konradwilk/fibonacci/(threads)

Thread 6 (2021-06-09):

remove clock buffers on outputs

mattvenn, 2021-06-09:
add this to config.tcl and re-harden. See thread in #mpw-2-prep for more details

set ::env(PL_RESIZER_BUFFER_OUTPUT_PORTS) 0

konradwilk, 2021-06-09:
Fixed in 4a7fbc5c31c69371d0a4e8706bc4d8c3d64965da

Closed 2021-06-09.
