konradwilk/fibonacci/caravel_test/test_caravel.py

# SPDX-FileCopyrightText: 2021 Konrad Rzeszutek Wilk
#
# Licensed under the Apache License, Version 2.0 (the "License");
# you may not use this file except in compliance with the License.
# You may obtain a copy of the License at
#
#      http://www.apache.org/licenses/LICENSE-2.0
#
# Unless required by applicable law or agreed to in writing, software
# distributed under the License is distributed on an "AS IS" BASIS,
# WITHOUT WARRANTIES OR CONDITIONS OF ANY KIND, either express or implied.
# See the License for the specific language governing permissions and
# limitations under the License.
# SPDX-License-Identifier: Apache-2.0
import cocotb
from cocotb.clock import Clock
from cocotb.binary import BinaryValue
from cocotb.triggers import ClockCycles, RisingEdge, FallingEdge;
from cocotb.result import TestSuccess;

@cocotb.test()
async def test_start(dut):
    clock = Clock(dut.clock, 10, units="ns")
    cocotb.fork(clock.start())

    dut.RSTB <= 0
    dut.power1 <= 0;
    dut.power2 <= 0;
    dut.power3 <= 0;
    dut.power4 <= 0;
    dut.uut.mprj.wrapper_fibonacci.wbs_dat_i.value <= 0;

    dut._log.info("Cycling power");
    await ClockCycles(dut.clock, 8)
    dut.power1 <= 1;
    await ClockCycles(dut.clock, 8)
    dut.power2 <= 1;
    await ClockCycles(dut.clock, 8)
    dut.power3 <= 1;
    await ClockCycles(dut.clock, 8)
    dut.power4 <= 1;

    await ClockCycles(dut.clock, 80)
    dut.RSTB <= 1

    dut._log.info("Waiting for active (This can take a while)");
    # wait for the project to become active
    # wrapper.v has  .active     (la_data_in[32+0])
    # wrapper.c: reg_la1_ena = 0;
    #            reg_la1_data = 1; /* 0x2500,0004 */
    await RisingEdge(dut.uut.mprj.wrapper_fibonacci.active)
    dut._log.info("Active ON");

async def test_wb(dut, i):

    ack_str = "";
    addr = int(dut.uut.mprj.wrapper_fibonacci.wbs_adr_i.value);
    data = int(dut.uut.mprj.wrapper_fibonacci.wbs_dat_o.value);
    ack = int(dut.uut.mprj.wrapper_fibonacci.wbs_ack_o.value);
    try:
        data_i = int(dut.uut.mprj.wrapper_fibonacci.wbs_dat_i.value);
    except:
        dut._log.info("%4d %s %s DATA_IN=RAW[%s] DATA_OUT=%s" % (i, hex(addr), ack_str,  dut.uut.mprj.wrapper_fibonacci.wbs_dat_i.value, hex(data)));
        pass

    if (addr >= 0x30000000):
        if (ack == 1):
            ack_str = "ACK";

        dut._log.info("%4d %s %s DATA_IN=%s DATA_OUT=%s" % (i, hex(addr), ack_str,  hex(data_i), hex(data)));

        if (ack == 0):
            return;

        if (addr == 0x30000000): # CTRL_GET_NR
            assert(data == 9);

        if (addr == 0x30000004): # CTRL_GET_ID
            assert(data == 0x4669626f);

        if (addr == 0x30000020): # CTRL_PANIC
            assert (data_i == 0x0badf00d); # It is a write..

            raise TestSuccess

@cocotb.test()
async def test_values(dut):
    clock = Clock(dut.clock, 10, units="ns")
    cocotb.fork(clock.start())

    # wait for the reset (
    dut._log.info("Waiting for reset");

    #         /* .reset(la_data_in[0]) */
    # reg_la0_ena = 0; /* 0x2500,0010 */
    # reg_la0_data = 1; /* RST on 0x2500,0000*/

    await RisingEdge(dut.uut.mprj.wrapper_fibonacci.Fibonacci.reset)
    await FallingEdge(dut.uut.mprj.wrapper_fibonacci.Fibonacci.reset)
    dut._log.info("Reset done");

    await ClockCycles(dut.clock,1)

    value = str(dut.mprj_io.value)[:-8].replace('z','');

    dut._log.info("dut.mprj_io=%d" % (int(value)));
    assert (int(value) == 0);

    prio_value = 0;
    p_prio_value = 0;

    for i in range(50):
        # We get these annoying 'ZZ' in there, so we do this dance to get rid of it.
        value = BinaryValue(str(dut.mprj_io.value)[:-8].replace('z',''));

        current_value  = int(value);

        if (i == 0) or ((i > 0) and ((i % 44) == 0)):
            prio_value = 0;
            p_prio_value = 0;
        if (i == 1) or ((i > 1) and ((i % 45) == 0)):
            p_prio_value = 0;
            prio_value = 1;

        #print("i = %d p_prio_value=%d,prio_value=%d,current_value=%d" % (i, p_prio_value, prio_value, current_value));
        assert (current_value == (prio_value + p_prio_value));
        if (i >= 2) and ((i % 44) and (i % 45)):
            p_prio_value = prio_value;
            prio_value = current_value;

        await ClockCycles(dut.clock,1)

    for i in range(300000):

        await ClockCycles(dut.clock,1)
        await test_wb(dut, i);
