konradwilk/fibonacci/(commit log)

2021-05-19 Initial commit.
    The test-case / Makefile has been repurposed from
    https://github.com/mattvenn/rgb_mixer
2021-05-19 verilog: Fix up code per verible-verilog-lint
    [fibonacci.v]
2021-05-19 fpga: Add top module and change WIDTH to 8
    .. so we can probe only on eight bits instead of 32.
2021-05-19 verilator: Fix clkdiv warnings (spaces)
    [clkdiv.v]
2021-05-19 wrapper: Add GTKWave and initial test-case
    Note that the -DMPRJ_IO_PADS=33 is set to 33 bits to make
    the test-case work which depends on 32-bits.
    (Otherwise we have to cut out on BinaryFormat the bits
    above 32).
2021-05-20 caravel: Firmware code and test harness.
    A couple of things:
    - You need to have this repo setup in your caravel repo under verilog/rtl/fibonacci
    - The contents of this directory MUST be in
    caravel/verilog/dv/caravel/user_proj_example/fibonacci
    - You need to edit the user_project_example.v to instantiate the
    wrapper.v from the root directory of this git repo:
    wrapper proj_0 (
    // interface as user_proj_example.v
    .wb_clk_i (wb_clk_i),
    .wb_rst_i (wb_rst_i),
    .wbs_stb_i (wbs_stb_i),
    .wbs_cyc_i (wbs_cyc_i),
    .wbs_we_i (wbs_we_i),
    .wbs_sel_i (wbs_sel_i),
    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
2021-05-20 Update to 0.15 of OpenLANE and Caravel shuttle two.
    Note that for caravel the other changes that were required :
    In verilog/rtl/uprj_netlists.v add:
    `include "fibonacci/wrapper.v"
    `include "fibonacci/src/fibonacci.v"
    In verilog/rtl/user_project_wrapper.v
    - change the name (to wrapper),
    - limit the amount of pins:
    .la_data_in(la_data_in[31:0]),
    .la_data_out(la_data_out[31:0]),
    .la_oenb (la_oenb[31:0]),
    - add active to latch on 33rd pin:
    .active(la_data_in[32+0])
2021-05-20 wrapper: Fix to MPRJ_IO_PADS
    Now in Caravel it is replication syntax.
    [wrapper.v]
2021-05-20 openlane: Add pin_order.cfg file
    [pin_order.cfg]
2021-05-21 wrapper: Don't use [7:0] pins
    As those are used by the SPI. Which means we will need
    to shift up to the 37:8 and emit only 30 bits of numbers.
    Also truncate the test-case (really the right way would be
    to compute when we hit the high bits and then change the
    prev_values and p_prev_values ... but this is OK for right
    now).
2021-05-21 verilog: Fix indent and minor test-case issue
    (Now that we use .on(1), that needed to be set in the
    test-case).
    [fpga.v, test_fibonacci.py, wrapper.v]
2021-05-21 verilog: buf_wbs_dat_o is wire, so need register
    which means all of the values are to go there.
    Also it make it easier to read the case statements.
2021-05-21 testcase: Fix the 'ZZ' part and truncation to 30 bits.
    [test_wrapper.py]
2021-05-21 verilog: CTRL_FIBONACCI_[ON,OFF] should be just CTRL_FIBONACCI_CTRL.
    And also fix up some more lint warnings.
    [wrapper.v]
2021-05-22 verilog: fix clock
    It ended up with always being 0.
    [wb_logic.v, wrapper.v]
2021-05-22 verilog: Fix lint warnings about BASE_ADDRESS
    [wb_logic.v]
2021-05-22 firmware: Fix up the right defines
    [dump_wb_logic.v, test_wb_logic.py, wb_logic.v, wrapper.c]
2021-05-22 sby: Move the flip flops where the we write to them.
    [wb_logic.v]
2021-05-22 verilog: It is 32 bits on wbs_adr_i, not 33
    Not sure when it creeped up but this is wrong.
    [wb_logic.v, wrapper.v]
2021-05-22 test: Use dut logging instead of print
2021-05-22 caravel: Finish up the test-case
    We bail out (everything went fine) when CTRL_PANIC has 0xbadf00d.
2021-05-22 Revert "verilog: Drop the checking of values _after_ a write."
    This reverts commit aa8b80f6d7d00151bd46c78d06f1dafed5d3200c.
    [test_wb_logic.py, wb_logic.v]
2021-05-22 wishbone: Squash the read/write together
    This makes it possible for the SBY to work and not
    complain about multiple drivers of buffer_o.
2021-05-22 verilog: Lint fixes
    Both cases the amount of bits was incorrect.
    [wb_logic.v]
2021-05-22 caravel_test: Fix up the exception mechanism
    [test_caravel.py]
2021-05-22 testcase: Remove old prints
    They are not needed anymore.
2021-05-22 verilog: Add the default_nettype wire
2021-05-22 GDS: Move the test case for gate level simulation in GDS
2021-05-22 test_case: Fix up the logging and don't use the clock.
    [test_caravel.py]
2021-05-23 multi_tool: Add makefile stanze to run it.
    It keeps on failing at:
    ERROR - wrong number of tristates [sky130_fd_sc_hd__ebufn_] 150 in
    /home/zerotoasic/fibonacci/gds/wrapper_fibonacci.lvs.powered.v
    zerotoasic@zerotoasic:~/multi_project_tools$
2021-05-23 clkdiv: Fix it to actually work.
    As it keep giving 'xxx' for counter values
    [clkdiv.v, wrapper.v]
2021-05-24 clkdiv: Partial revert of "clkdiv: Fix it to actually work."
    As it certainly did not make it work when running under
    caravel.
    Fixes: (8a06822c) "clkdiv: Fix it to actually work."
    [clkdiv.v, test_wb_logic.py, wb_logic.v, wrapper.v]
2021-05-25 Makefile: Run the GL test-case after we have generated the new file
    .. so that we can spot issues as part of the workflow.
2021-05-25 test: Set all of the wishbone values to zero at init.
    The original issue (which Matt fixed) was that wb_active
    was depending on wb_cyc_i and wb_stb_i. Since those were
    undefined all the logic around wb_active and the decisions
    on that ended up being undefined.
    That meant the simulator would decide that since it is undefined,
    then_ALL_ paths could be taken and simulate every read/write
    case statement, causing a ripling effect in the simulator
    and leading to the testcase failing.
    While in reality if the GDS was used there would be no hardware
    failure as the firmware would have reset the wb_cyc_i and wb_stb_i
    to known values.
    [test_wrapper.py]
2021-05-26 README: Update it with the picture of the die
2021-05-26 test: Expand test_wb_logic to cover GL generated code as well
    To a certain extend. Some of the wires are called \WishBone,
    and those don't seem to work out as:
    dut.\WishBone.panic
    or such, so we skip those tests.
    [test_wb_logic.py]
2021-06-04 test: Update it to deal with Z and X in wbs_dat_i after interrupt
    as it seems we haven't initialized some values on the wishbone
    so it goes all wonky. Lets just deal with those access patterns.
2021-06-06 verilog: Fix indentation
    Used https://github.com/bmartini/vdent which does a pretty
    good job at making the code look much better. Did have to
    manually modify the case statements without begin/end.
    [clkdiv.v, fibonacci.v, fpga.v, wb_logic.v, wrapper.v]
2021-06-08 changes for userclock2
    [pin_order.cfg]
2021-07-20 test: Wrap in the TB the wrapper_fibonacci
    .. instead of having it standalone. That allows us
    to be able to reference the 'status' register.
    But it also uncovered some other issues in the code such
    as the test-cases not being prepared to be run from
    a module higher than wrapper_fibonacci and needing the
    logic to handle that.
    The GL detection logic is not really working right either.
    It will always set GL to true when running with the dump_wrapper.v
    because the power1,power2 are in it (even if using the LVS
    as well both of those are used). Will have to be reworked.
    [dump_wrapper.v, test_wb_logic.py, test_wrapper.py]
2021-07-21 tests: Keep reset low at startup
    [test_wrapper.py]
2021-07-21 test: Add alias to dut.la_data_in[0] called reset.
    [dump_wrapper.v]
2021-07-22 visualize: Generate heatmaps of GL/GDS code
    Anish Singhani wrote a neat visualizaiton tool:
    https://github.com/asinghani/sky130-chip-vis
    which is able to generate gif's that need the
    'status' register in the top wrapper of the simulation,
    along with the 'reset' wire.
    The prior patches did this and now we are peppering the
    test-cases with those 'status' values.
    While this makes the tool run nicely:
    Parsing netlist using yosys (slow)...
    Execute: [yosys -p "read_verilog -sv build/tmp_sky130_fd_sc_hd_cells_fixed.v gds/wrapper_fibonacci.lvs.powered.v ; write_json ./design.json;" > ./yosys.log]
    Reading design
    Version: Yosys 0.9+4081 (open-tool-forge build) (git sha1 862e84eb, gcc 9.3.0-17ubun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
    [test_wb_logic.py, test_wrapper.py]
2021-07-22 README/Makefile: Update readme file and pick heatmode
    to visualize the LVS running against the test_wrapper
    and test_wb_logic testcases.
2021-07-22 tests: Fix the extra 0x0x on the 'status'
    No need for the extra 0x
    [test_wb_logic.py]
2021-07-22 Redux tests: Turn off/on fibonacci module when not needed
    For this test to work we need to have the switch turned
    back on.
2021-07-22 tests: Detect GL files properly
    By looking for the correct names now.
    [test_wb_logic.py]
